henryclaessonVT/darpa-sense-hardware/Colossus/Colossus_TI_rev_B/Colossus_TI_rev_B Specific Libraries/xwing/1688178384_Starwarsshutlle1-3969009895.png

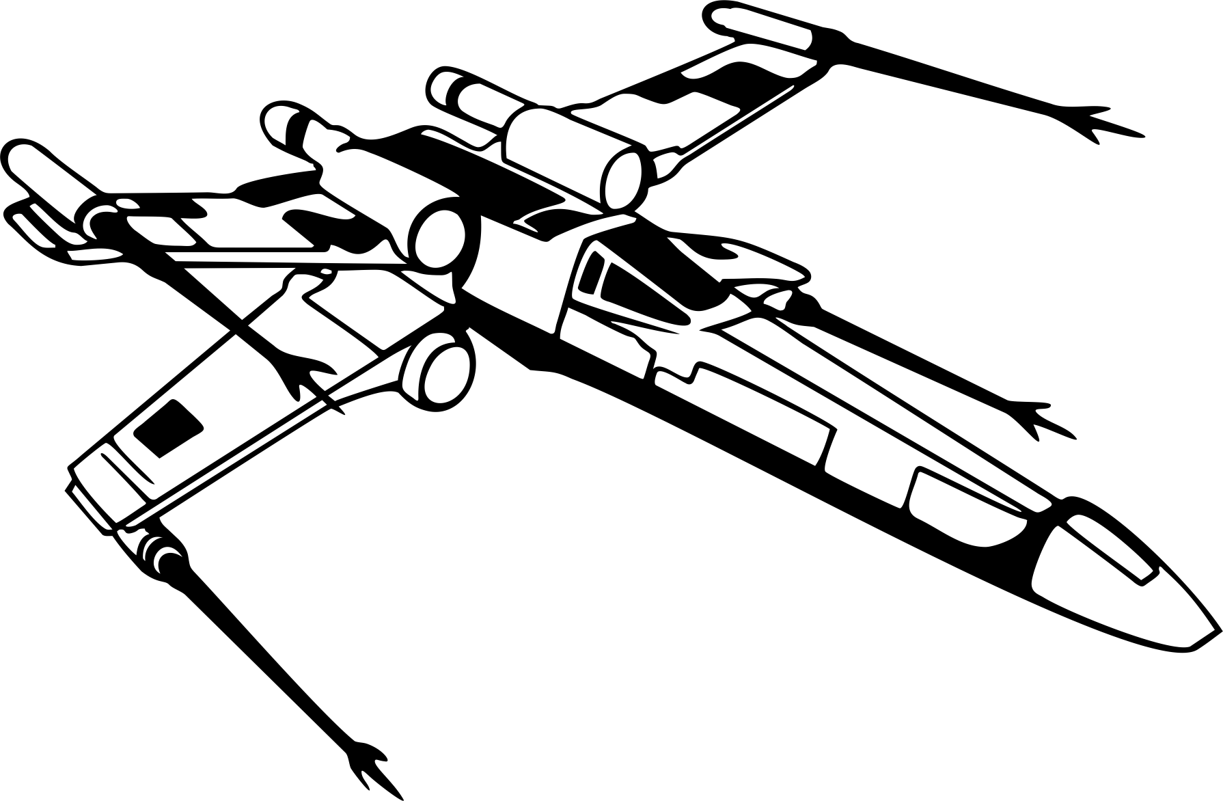
Colossus/Colossus_TI_rev_B/Colossus_TI_rev_B Specific Libraries/xwing/1688178384_Starwarsshutlle1-3969009895.png
