henryclaessonVT/darpa-sense-hardware/Colossus/Colossus_rev_C/Project Specific Libraries/LD56100DPU33R/DFN8_1P6X1P2_STM.step

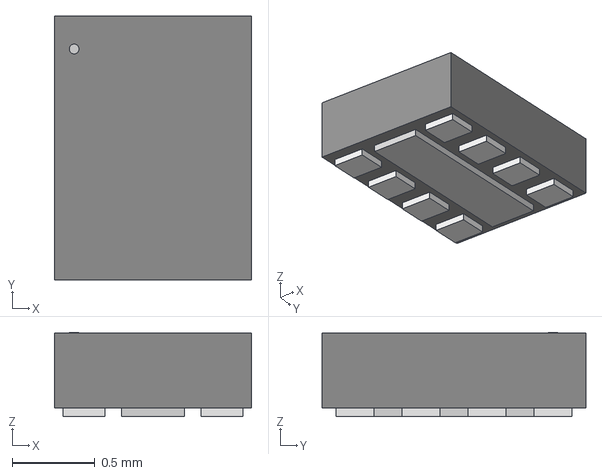
[picture p2: CAD file, 2025-03-21]
Colossus/Colossus_rev_C/Project Specific Libraries/LD56100DPU33R/DFN8_1P6X1P2_STM.step
1.19 x 1.60 x 0.511 mm
