henryclaessonVT/darpa-sense-hardware/Colossus/Colossus_rev_C/Project Specific Libraries/stm32/WLCSP39_STM.step

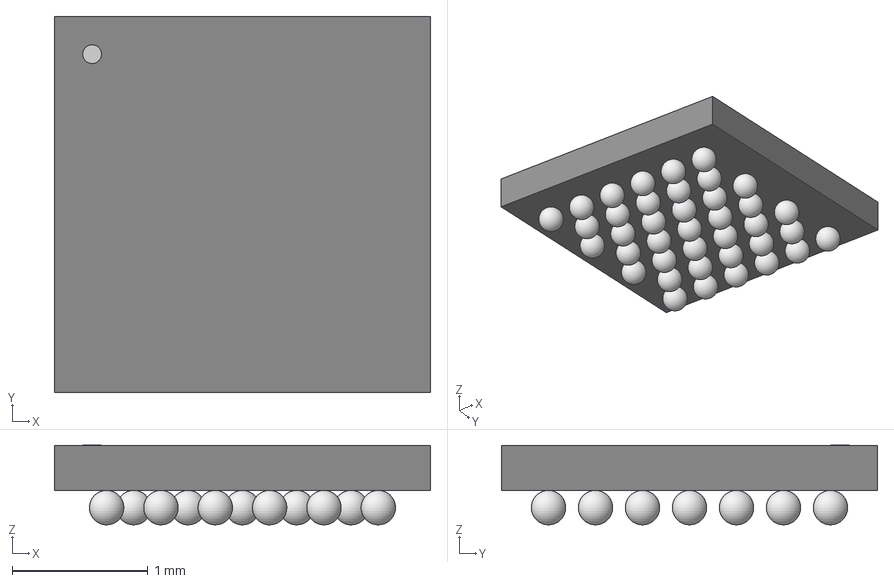
[picture p3: CAD file, 2025-03-21]
Colossus/Colossus_rev_C/Project Specific Libraries/stm32/WLCSP39_STM.step
2.77 x 2.77 x 0.587 mm
