henryclaessonVT/darpa-sense-hardware/Colossus/Colossus_TI_rev_B/Colossus_TI_rev_B Specific Libraries/Analog Switch - SN74LVC1G3157DSFR/SN74LVC1G3157DSFR.step

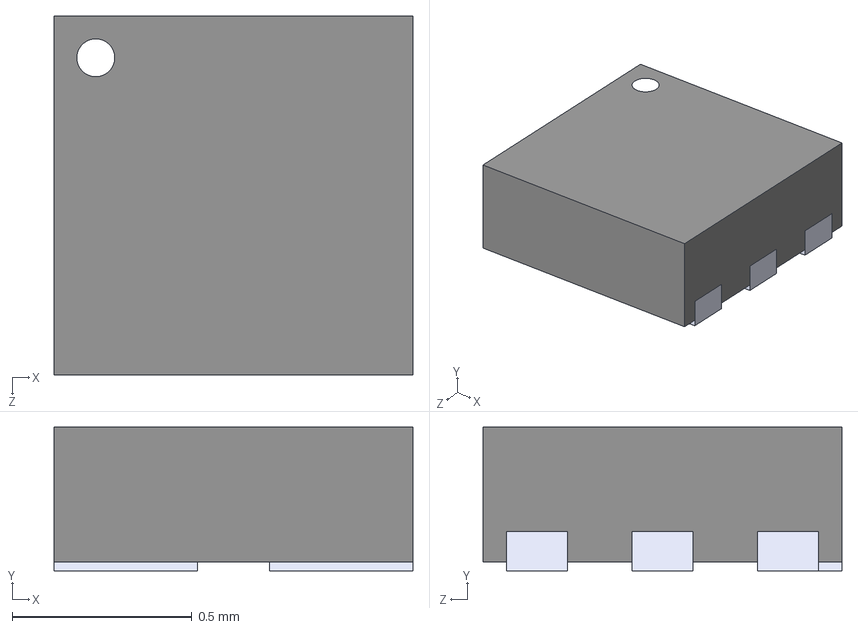
[picture p4: CAD file, 2025-08-12]
Colossus/Colossus_TI_rev_B/Colossus_TI_rev_B Specific Libraries/Analog Switch - SN74LVC1G3157DSFR/SN74LVC1G3157DSFR.step
1.00 x 0.4 x 1.00 mm
