henryclaessonVT/darpa-sense-hardware/Colossus/Colossus_TI_rev_B/Colossus_TI_rev_B Specific Libraries/G_107_0513 - Switch/G-107-0513.step

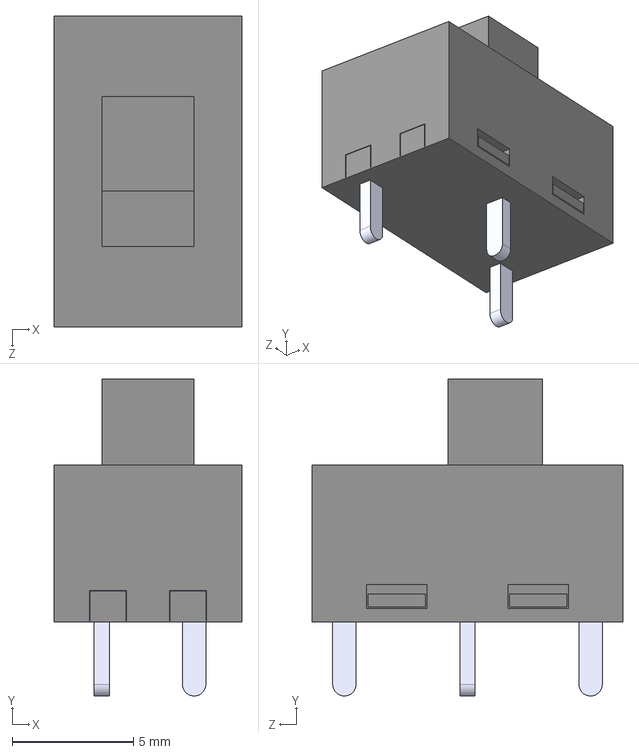
[picture p5: CAD file, 2025-04-02]
Colossus/Colossus_TI_rev_B/Colossus_TI_rev_B Specific Libraries/G_107_0513 - Switch/G-107-0513.step
7.75 x 13.1 x 12.8 mm
