henryclaessonVT/darpa-sense-hardware/Colossus/Colossus_TI_rev_B/Colossus_TI_rev_B.step

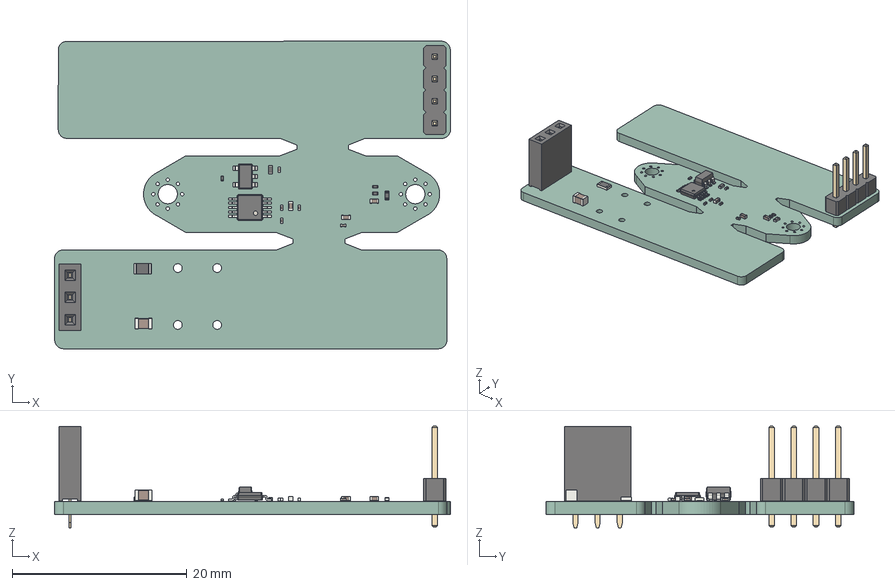
[picture p6: CAD file, 2025-08-12]
Colossus/Colossus_TI_rev_B/Colossus_TI_rev_B.step
45.3 x 35.2 x 11.6 mm
C_0402_1005Metric x 3
C_0201_0603Metric x 5
R_0201_0603Metric x 3
R_0402_1005Metric x 2
SOT-23-5
PinHeader_1x04_P2.54mm_Vertical
PinSocket_1x03_P2.54mm_Vertical
MSOP-10_3x3mm_P0.5mm
R_0805_2012Metric
C_0805_2012Metric
Colossus_TI_rev_B_PCB
