henryclaessonVT/darpa-sense-hardware/Colossus/Colossus_TI_rev_B/Colossus_TI_rev_B Specific Libraries/CSD18541F5 - n channel mosfet/CSD18541F5.step

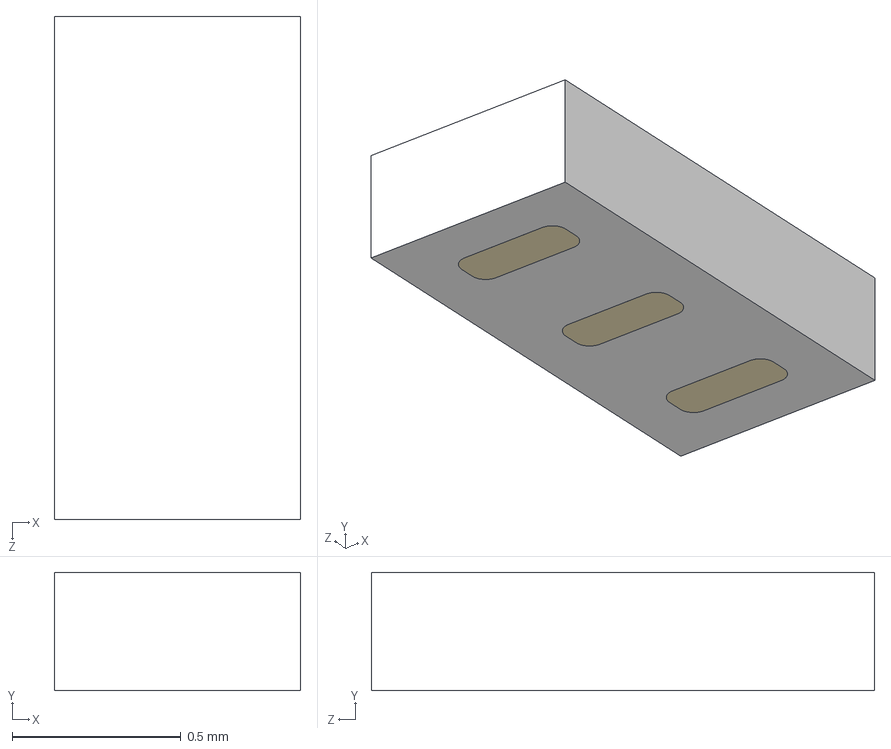
[picture p7: CAD file, 2025-05-27]
Colossus/Colossus_TI_rev_B/Colossus_TI_rev_B Specific Libraries/CSD18541F5 - n channel mosfet/CSD18541F5.step
0.73 x 0.35 x 1.49 mm
