henryclaessonVT/darpa-sense-hardware/(list of files, cad)

Other CAD files:
Colossus/Colossus_rev_C/Project Specific Libraries/WLCSP39_STM.step
