henryclaessonVT/darpa-sense-hardware/Colossus/Colossus_TI_rev_B/plots/Colossus_TI_rev_B__Assembly.pdf

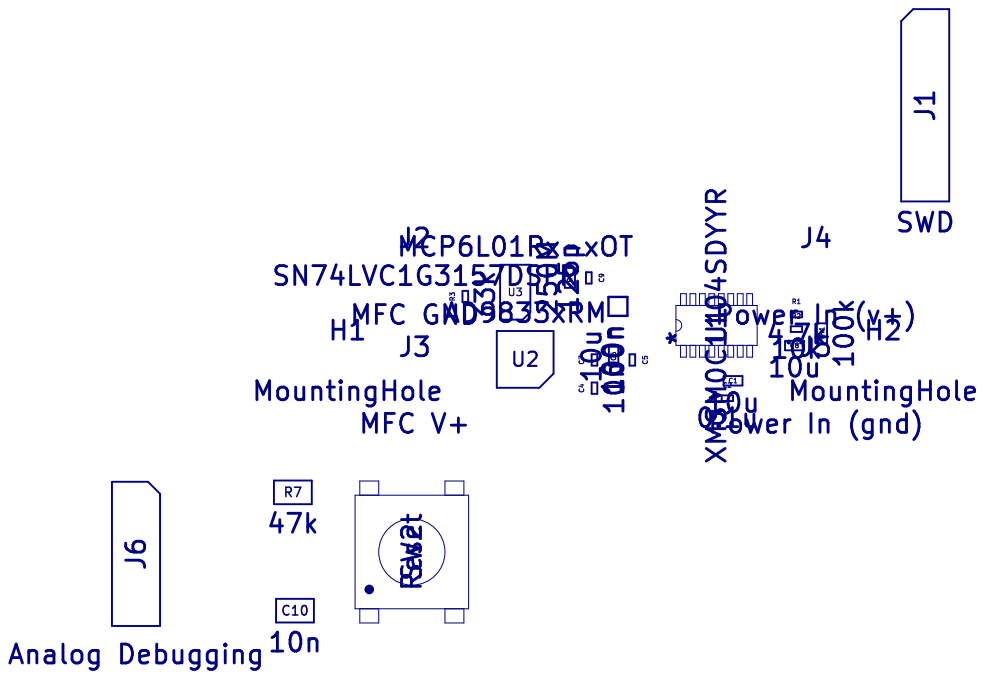
[picture p8: page 1]

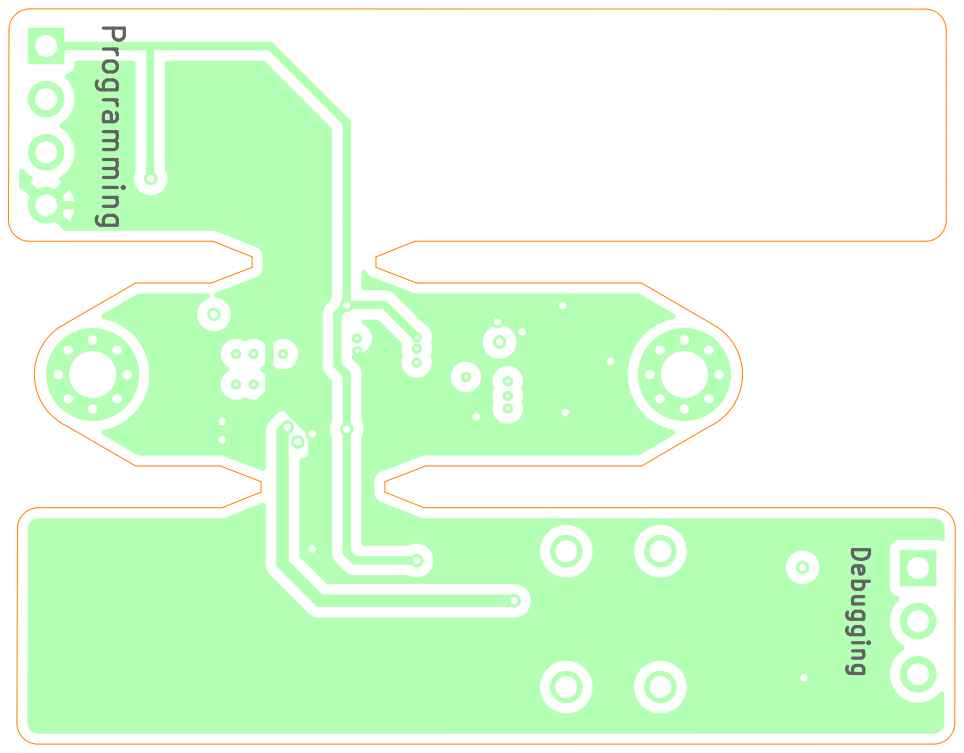
[picture p9: page 2]
Debugging Programming; D Date: KiCad; E.D.A. 9.0.1 Size: A4; Rev:; Id: /1 Title: File: Colossus_TI_rev_B.kicad_pcb Sheet: Colored; BOT Board2Pdf:; Colored; BOT -; Page 2/2
