henryclaessonVT/darpa-sense-hardware/Colossus/Colossus_TI_rev_B/Colossus_TI_rev_B.kicad_pcb

## KiCad design Colossus/Colossus_TI_rev_B/Colossus_TI_rev_B.kicad_pcb (2025-08-12)

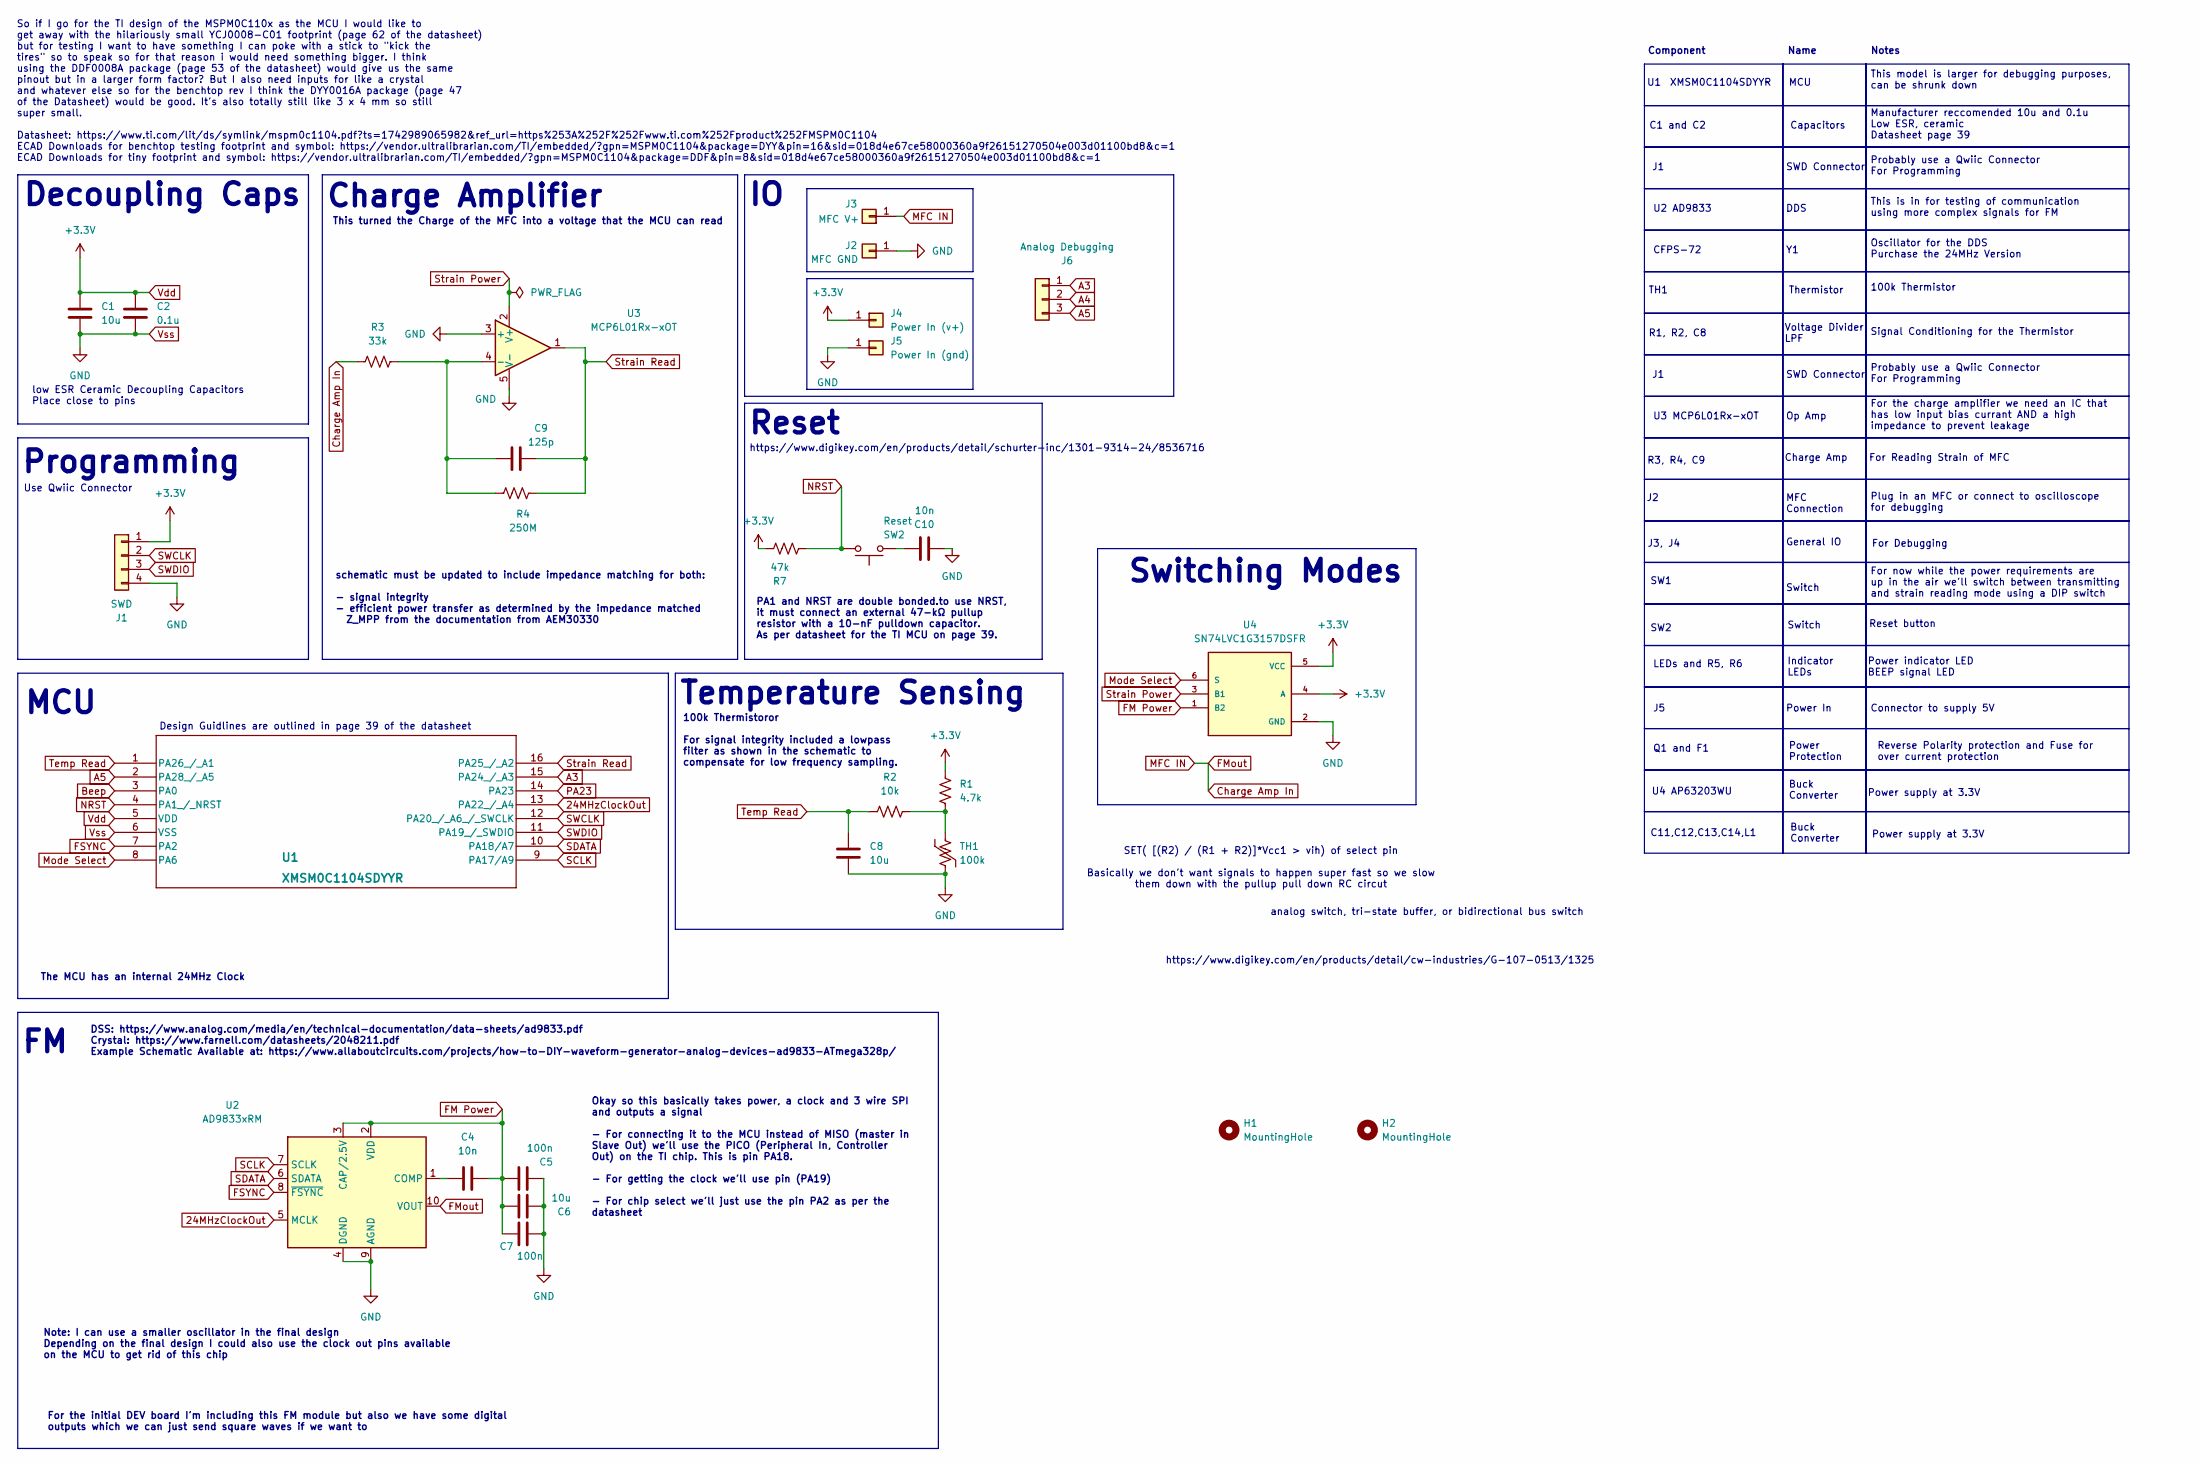
[picture p10: schematic Colossus_TI_rev_B.kicad_sch]

Parts:
C1, C6, C8: 10u; C_0402_1005Metric
C2: 0.1u; C_0201_0603Metric
C4: 10n; C_0201_0603Metric
C5, C7: 100n; C_0201_0603Metric
C9: 125p; C_0201_0603Metric
C10: 10n; C_0805_2012Metric
H1, H2: MountingHole; MountingHole_2.2mm_M2_Pad_Via
J1: SWD; PinHeader_1x04_P2.54mm_Vertical
J2: MFC GND; TestPoint_Pad_2.0x2.0mm
J3: MFC V+; TestPoint_Pad_2.0x2.0mm
J4: Power In (v+); TestPoint_Pad_2.0x2.0mm
J5: Power In (gnd); TestPoint_Pad_2.0x2.0mm
J6: Analog Debugging; PinSocket_1x03_P2.54mm_Vertical
R1: 4.7k; R_0201_0603Metric
R2: 10k; R_0201_0603Metric
R3: 33k; R_0201_0603Metric
R4: 250M; R_0402_1005Metric
R7: 47k; R_0805_2012Metric
SW2: Reset; SW_B3F-1000_OMR
TH1: 100k; R_0402_1005Metric
U1: XMSM0C1104SDYYR; SOT-23-THIN16_DYY_TEX
U2: AD9833xRM; MSOP-10_3x3mm_P0.5mm
U3: MCP6L01Rx-xOT; SOT-23-5
U4: SN74LVC1G3157DSFR; SON35P100X100X40-6N; PARTREV M

Connections:
24MHzClockOut: U1.13 (PA22_/_A4), U2.5 (MCLK)
A3: J6.1, U1.15 (PA24_/_A3)
A4: J6.2
A5: J6.3, U1.2 (PA28_/_A5)
Beep: U1.3 (PA0)
Charge Amp In: J3.1, R3.1, U2.10 (VOUT)
FM Power: C4.2, C5.2, C6.2, C7.1, U2.2 (VDD), U2.3 (CAP/2.5V), U4.1 (B2)
FSYNC: U1.7 (PA2), U2.8 (~FSYNC)
Mode Select: U1.8 (PA6), U4.6 (S)
NRST: R7.2, SW2.2, U1.4 (PA1_/_NRST)
unnamed: C10.2, SW2.1
unnamed: R1.2, R2.2, TH1.2
unnamed: C4.1, U2.1 (COMP)
unnamed: C9.1, R3.2, R4.1, U3.4 (-)
PA23: U1.14 (PA23)
SCLK: U1.9 (PA17/A9), U2.7 (SCLK)
SDATA: U1.10 (PA18/A7), U2.6 (SDATA)
SWCLK: J1.2, U1.12 (PA20_/_A6_/_SWCLK)
SWDIO: J1.3, U1.11 (PA19_/_SWDIO)
Strain Power: U3.2 (V+), U4.3 (B1)
Strain Read: C9.2, R4.2, U1.16 (PA25_/_A2), U3.1
Temp Read: C8.2, R2.1, U1.1 (PA26_/_A1)
Vdd: C1.1, C2.1, J1.1, J4.1, R1.1, R7.1, U1.5 (VDD), U4.4 (A), U4.5 (VCC)
Vss: C1.2, C2.2, C5.1, C6.1, C7.2, C8.1, C10.1, J1.4, J2.1, J5.1, TH1.1, U1.6 (VSS), U2.4 (DGND), U2.9 (AGND), U3.3 (+), U3.5 (V-), U4.2 (GND)

Notes on the sheet:
J3, J4
TH1
Buck Converter
DDS
For the initial DEV board I'm including this FM module but also we have some digital outputs which we can just send square waves if we want to
Notes
Power supply at 3.3V
Charge Amp
Design Guidlines are outlined in page 39 of the datasheet
Note: I can use a smaller oscillator in the final design Depending on the final design I could also use the clock out pins available on the MCU to get rid of this chip
Switch
low ESR Ceramic Decoupling Capacitors Place close to pins
C1 and C2
For the charge amplifier we need an IC that has low input bias currant AND a high impedance to prevent leakage
Power indicator LED BEEP signal LED
Temperature Sensing
Plug in an MFC or connect to oscilloscope for debugging
Voltage Divider LPF
U4 AP63203WU
General IO
Power Protection
analog switch, tri-state buffer, or bidirectional bus switch
Probably use a Qwiic Connector For Programming
For now while the power requirements are up in the air we'll switch between transmitting and strain reading mode using a DIP switch
Programming
U2 AD9833
Charge Amplifier
Manufacturer reccomended 10u and 0.1u Low ESR, ceramic Datasheet page 39
This turned the Charge of the MFC into a voltage that the MCU can read
schematic must be updated to include impedance matching for both: - signal integrity - efficient power transfer as determined by the impedance matched Z_MPP from the documentation from AEM30330
Switching Modes
Name
Power In
C11,C12,C13,C14,L1
Decoupling Caps
Capacitors
Connector to supply 5V
Use Qwiic Connector
SET( [(R2) / (R1 + R2)]*Vcc1 > vih) of select pin Basically we don't want signals to happen super fast so we slow them down with the pullup pull down RC circut
Component
CFPS-72
This is in for testing of communication using more complex signals for FM
MCU
For Reading Strain of MFC
This model is larger for debugging purposes, can be shrunk down
100k Thermistor
Reset
Q1 and F1
Oscillator for the DDS Purchase the 24MHz Version
SW2
The MCU has an internal 24MHz Clock
https://www.digikey.com/en/products/detail/schurter-inc/1301-9314-24/8536716
MFC Connection
U3 MCP6L01Rx-xOT
Op Amp
Indicator LEDs
R3, R4, C9
Thermistor
So if I go for the TI design of the MSPM0C110x as the MCU I would like to get away with the hilariously small YCJ0008-C01 footprint (page 62 of the datasheet) but for testing I want to have something I can poke with a stick to "kick the tires" so to speak so for that reason i would need something b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
Reverse Polarity protection and Fuse for over current protection
https://www.digikey.com/en/products/detail/cw-industries/G-107-0513/1325
SWD Connector
R1, R2, C8
PA1 and NRST are double bonded.to use NRST, it must connect an external 47-kΩ pullup resistor with a 10-nF pulldown capacitor. As per datasheet for the TI MCU on page 39.
Reset button
100k Thermistoror For signal integrity included a lowpass filter as shown in the schematic to compensate for low frequency sampling.
Signal Conditioning for the Thermistor
For Debugging
DSS: https://www.analog.com/media/en/technical-documentation/data-sheets/ad9833.pdf Crystal: https://www.farnell.com/datasheets/2048211.pdf Example Schematic Available at: https://www.allaboutcircuits.com/projects/how-to-DIY-waveform-generator-analog-devices-ad9833-ATmega328p/
XMSM0C1104SDYYR
LEDs and R5, R6
Okay so this basically takes power, a clock and 3 wire SPI and outputs a signal - For connecting it to the MCU instead of MISO (master in Slave Out) we'll use the PICO (Peripheral In, Controller Out) on the TI chip. This is pin PA18. - For getting the clock we'll use pin (PA19) - For chip select we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
SW1

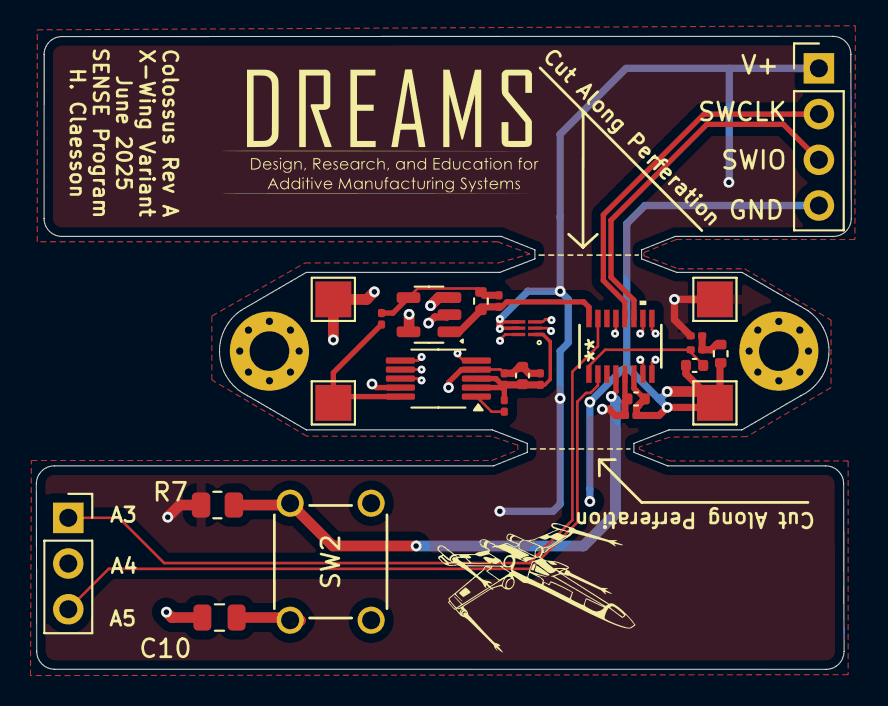
[picture p11: board Colossus_TI_rev_B.kicad_pcb from above]

Board: 4 copper layers, 45.3 x 35.2 mm, 28 parts (0 on the bottom side), 21 nets.
