henryclaessonVT/darpa-sense-hardware/Colossus/Colossus_rev_C/Colossus_rev_C.kicad_pcb

## KiCad design Colossus/Colossus_rev_C/Colossus_rev_C.kicad_pcb (2025-03-25)

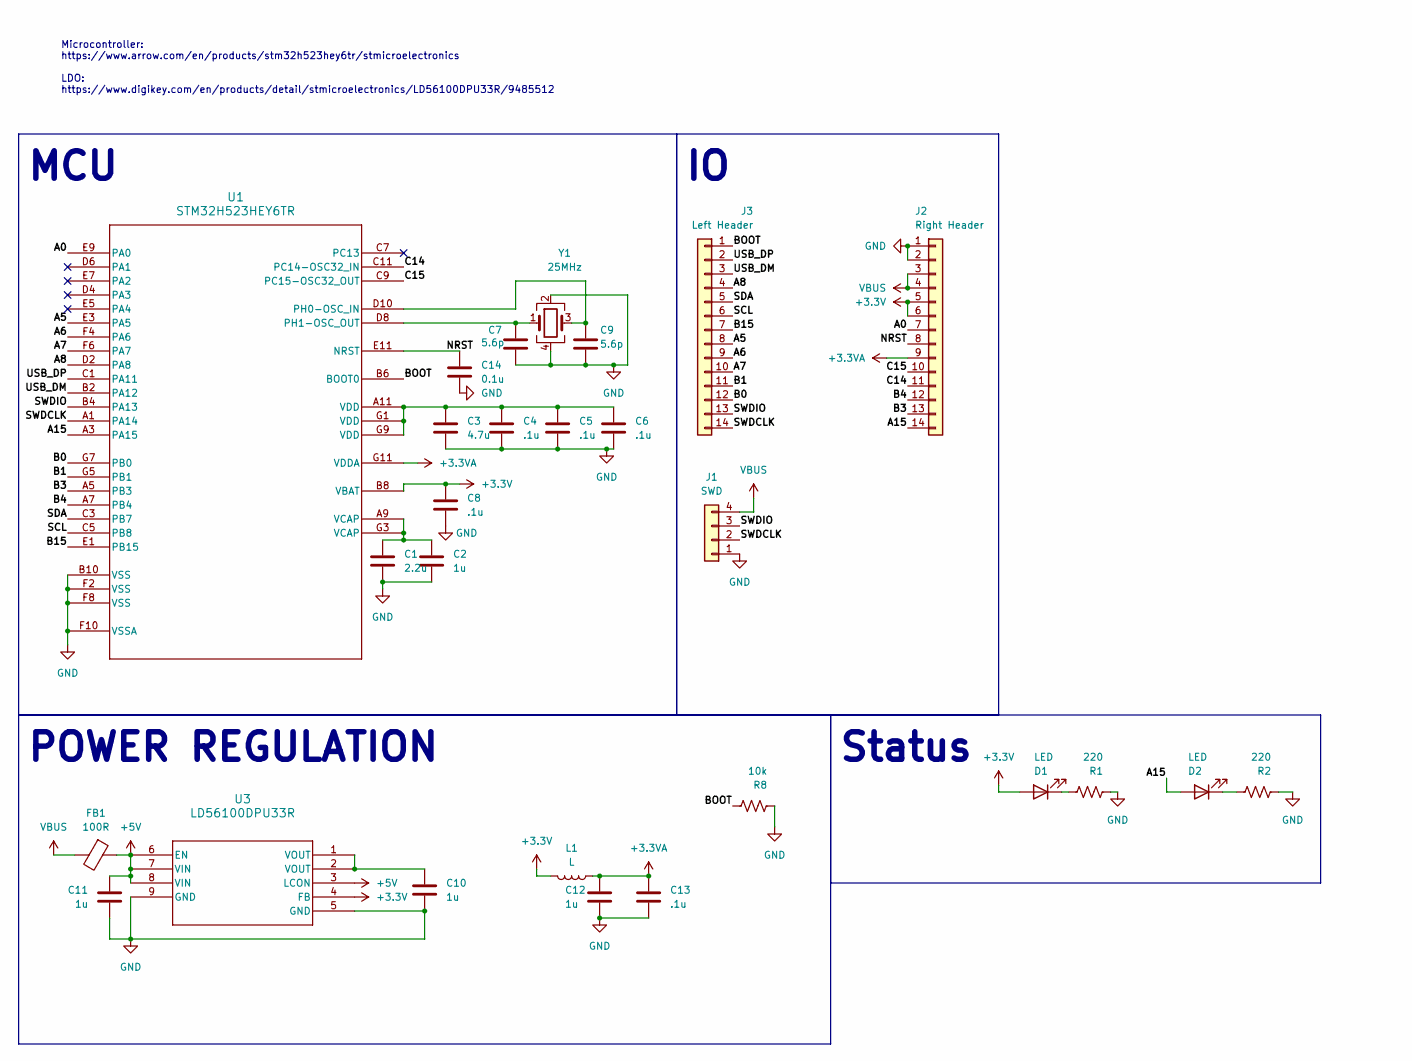
[picture p12: schematic Colossus_rev_C.kicad_sch, part in row 1, column 1]

Parts:
C1: 2.2u; C_0201_0603Metric
C2, C10, C11, C12: 1u; C_0201_0603Metric
C3: 4.7u; C_0201_0603Metric
C4, C5, C6, C8, C13: .1u; C_0201_0603Metric
C7, C9: 5.6p; C_0201_0603Metric
C14: 0.1u; C_0201_0603Metric
D1, D2: LED; LED_0201_0603Metric
FB1: 100R; LED_0201_0603Metric
J1: SWD; PinHeader_1x04_P1.00mm_Vertical
J2: Right Header; PinHeader_1x14_P1.27mm_Vertical
J3: Left Header; PinHeader_1x14_P1.27mm_Vertical
L1: L; L_0201_0603Metric
R1, R2: 220; R_01005_0402Metric
R8: 10k; R_01005_0402Metric
U1: STM32H523HEY6TR; WLCSP39_STM
U3: LD56100DPU33R; DFN8_1P6X1P2_STM-M
Y1: 25MHz; Oscillator_SMD_Abracon_ASCO-4Pin_1.6x1.2mm

Connections:
+3.3V: C8.1, D1.2 (A), J2.5, J2.6, L1.2, U1.B8 (VBAT), U3.4 (FB)
+3.3VA: C12.1, C13.1, J2.9, L1.1, U1.G11 (VDDA)
+5V: C11.1, FB1.1, U3.3 (LCON), U3.6 (EN), U3.7 (VIN), U3.8 (VIN)
/A0: J2.7, U1.E9 (PA0)
/A5: J3.8, U1.E3 (PA5)
/A6: J3.9, U1.F4 (PA6)
/A7: J3.10, U1.F6 (PA7)
/A8: J3.4, U1.D2 (PA8)
/A15: D2.2 (A), J2.14, U1.A3 (PA15)
/B0: J3.12, U1.G7 (PB0)
/B1: J3.11, U1.G5 (PB1)
/B3: J2.13, U1.A5 (PB3)
/B4: J2.12, U1.A7 (PB4)
/B15: J3.7, U1.E1 (PB15)
/BOOT: J3.1, R8.1, U1.B6 (BOOT0)
/C14: J2.11, U1.C11 (PC14-OSC32_IN)
/C15: J2.10, U1.C9 (PC15-OSC32_OUT)
/NRST: C14.1, J2.8, U1.E11 (NRST)
/SCL: J3.6, U1.C5 (PB8)
/SDA: J3.5, U1.C3 (PB7)
/SWDCLK: J1.2, J3.14, U1.A1 (PA14)
/SWDIO: J1.3, J3.13, U1.B4 (PA13)
/USB_DM: J3.3, U1.B2 (PA12)
/USB_DP: J3.2, U1.C1 (PA11)
GND: C1.2, C2.2, C3.2, C4.2, C5.2, C6.2, C7.2, C8.2, C9.2, C10.2, C11.2, C12.2, C13.2, C14.2, J1.1, J2.1, J2.2, R1.2, R2.2, R8.2, U1.B10 (VSS), U1.F2 (VSS), U1.F8 (VSS), U1.F10 (VSSA), U3.5 (GND), U3.9 (GND), Y1.2, Y1.4
unnamed: C1.1, C2.1, U1.A9 (VCAP), U1.G3 (VCAP)
unnamed: C3.1, C4.1, C5.1, C6.1, U1.A11 (VDD), U1.G1 (VDD), U1.G9 (VDD)
unnamed: C10.1, U3.1 (VOUT), U3.2 (VOUT)
unnamed: D1.1 (K), R1.1
unnamed: D2.1 (K), R2.1
unnamed: C9.1, U1.D10 (PH0-OSC_IN), Y1.3
unnamed: C7.1, U1.D8 (PH1-OSC_OUT), Y1.1
VBUS: FB1.2, J1.4, J2.3, J2.4

Notes on the sheet:
TODO: x Temperature Sensing Circuit o Strain Sensing Circuit -- skip this rev x IMU Circuit - MFC Communication Out Circuit - MFC Communication In Circuit - Energy Harvesting Circuit After that -- layout
Microcontroller: https://www.arrow.com/en/products/stm32h523hey6tr/stmicroelectronics LDO: https://www.digikey.com/en/products/detail/stmicroelectronics/LD56100DPU33R/9485512
MCU
POWER REGULATION
Status

Board: 2 copper layers, 27 parts (0 on the bottom side), 33 nets, no tracks yet.
