henryclaessonVT/darpa-sense-hardware/breakingboard/breakingboard.kicad_pcb

## KiCad design breakingboard/breakingboard.kicad_pcb (2025-01-02)

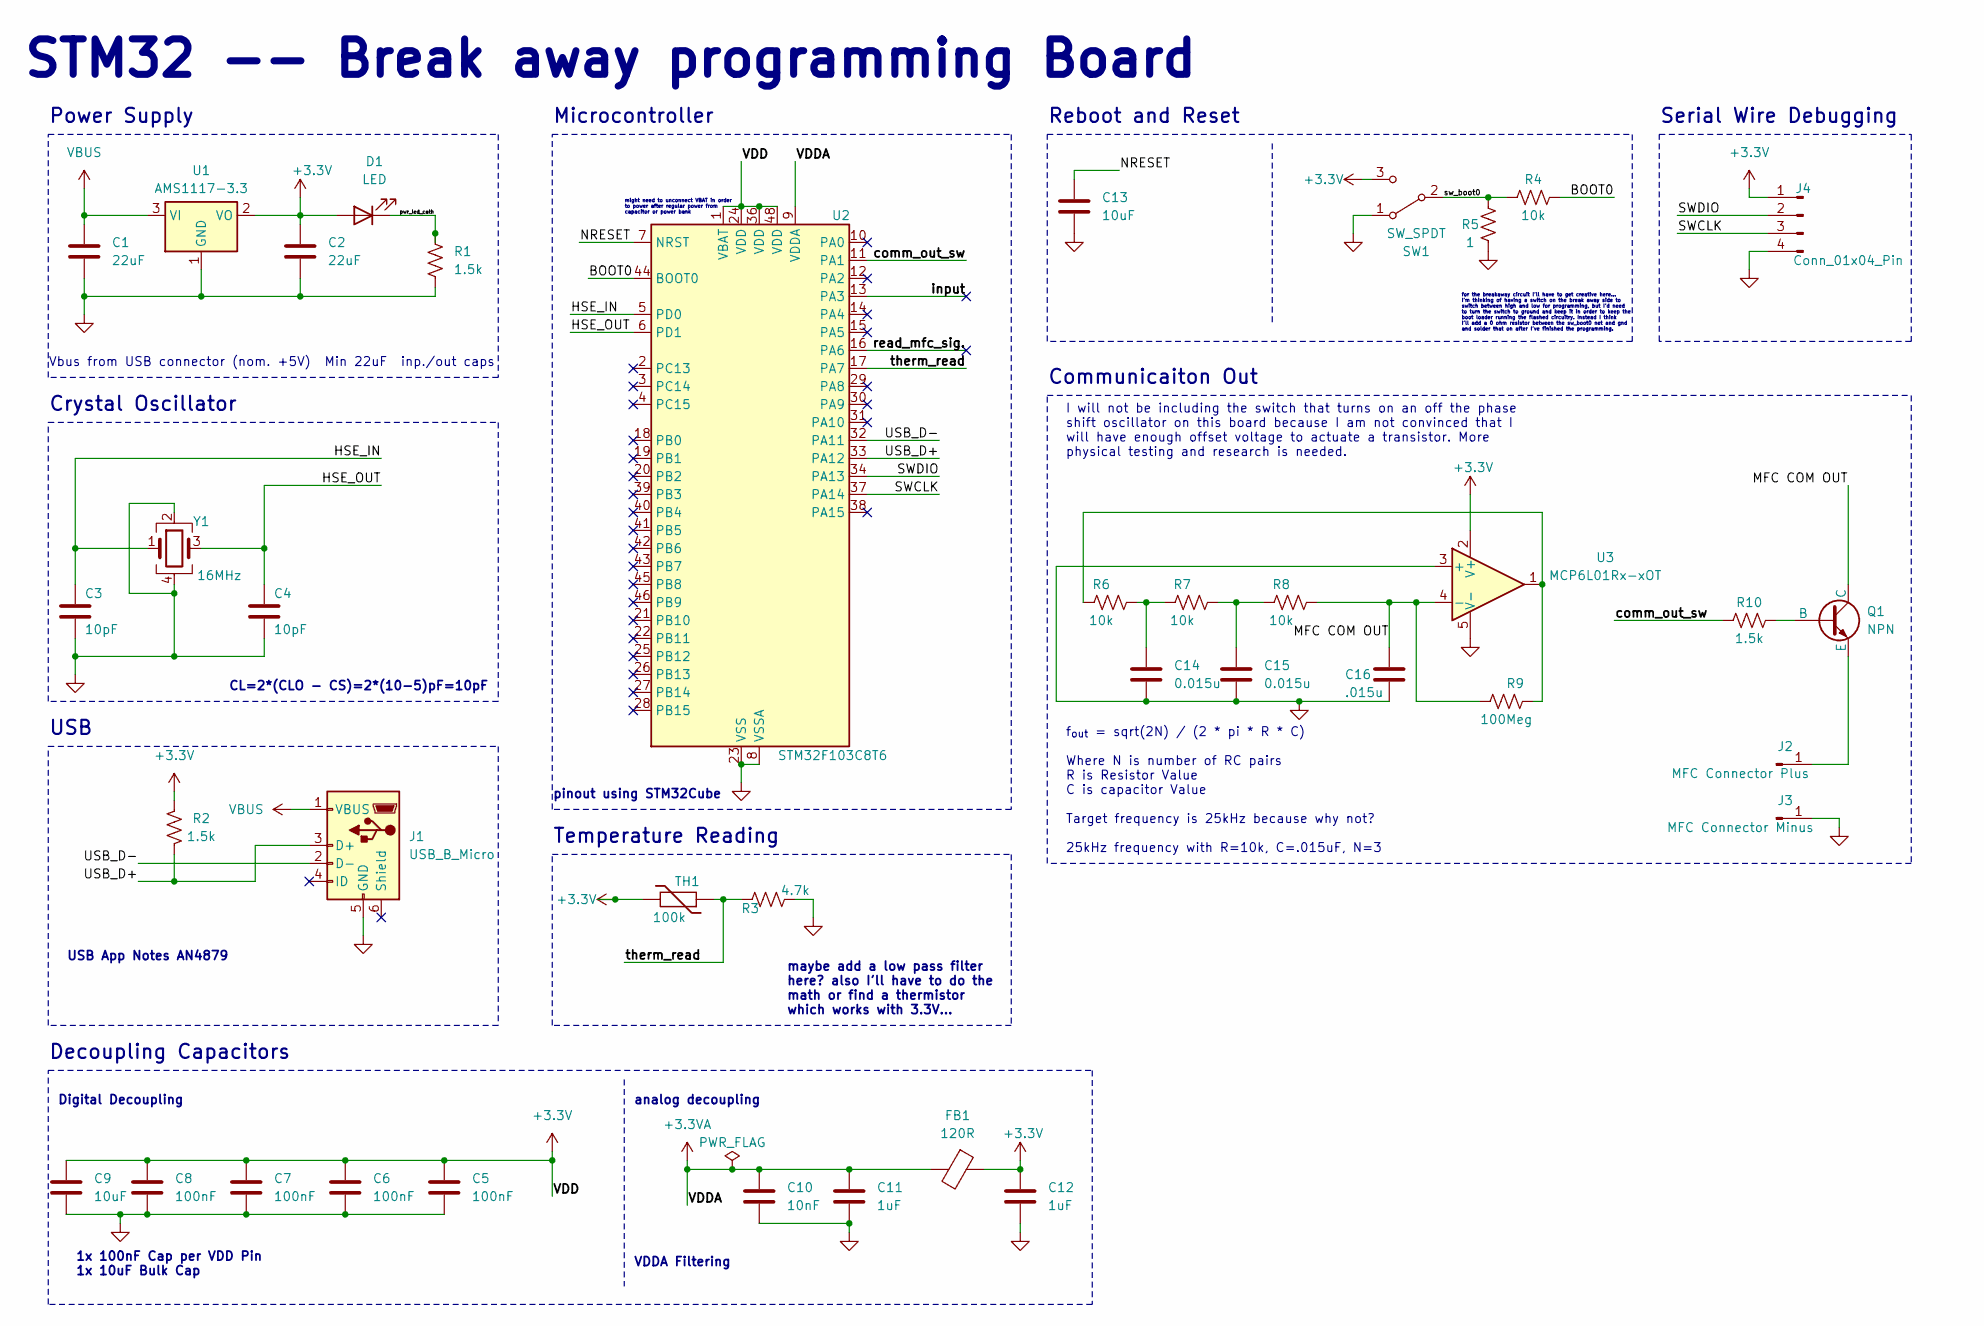
[picture p13: schematic breakingboard.kicad_sch, STM32 -- Break away programming Board]

Parts:
C1, C2: 22uF; C_0805_2012Metric
C3, C4: 10pF; C_0402_1005Metric
C5, C6, C7, C8: 100nF; C_0402_1005Metric
C9, C13: 10uF; C_0603_1608Metric
C10: 10nF; C_0402_1005Metric
C11, C12: 1uF; C_0402_1005Metric
C14, C15: 0.015u; C_0402_1005Metric
C16: .015u; C_0402_1005Metric
D1: LED; LED_0402_1005Metric
FB1: 120R; L_0603_1608Metric
J1: USB_B_Micro; USB_Micro-B_Wuerth_629105150521
J2: MFC Connector Plus; SolderWire-0.1sqmm_1x01_D0.4mm_OD1mm
J3: MFC Connector Minus; SolderWire-0.1sqmm_1x01_D0.4mm_OD1mm
J4: Conn_01x04_Pin; PinHeader_1x04_P2.54mm_Vertical
Q1: NPN; SOT-23
R1, R2, R10: 1.5k; R_0402_1005Metric
R3: 4.7k; R_0402_1005Metric
R4, R6, R7, R8: 10k; R_0402_1005Metric
R5: 1; R_0402_1005Metric
R9: 100Meg; R_0402_1005Metric
SW1: SW_SPDT; SW_SPDT_PCM12
TH1: 100k; R_0402_1005Metric
U1: AMS1117-3.3; SOT-223-3_TabPin2
U2: STM32F103C8T6; LQFP-48_7x7mm_P0.5mm
U3: MCP6L01Rx-xOT; SOT-23-5
Y1: 16MHz; Crystal_SMD_3225-4Pin_3.2x2.5mm

Connections:
+3.3V: C2.1, C5.1, C6.1, C7.1, C8.1, C9.1, C12.1, D1.2 (A), FB1.1, J4.1, R2.2, SW1.3 (C), TH1.2, U1.2 (VO), U2.1 (VBAT), U2.24 (VDD), U2.36 (VDD), U2.48 (VDD), U3.2 (V+)
+3.3VA: C10.1, C11.1, FB1.2, U2.9 (VDDA)
/BOOT0: R4.2, U2.44 (BOOT0)
/HSE_IN: C3.1, U2.5 (PD0), Y1.1
/HSE_OUT: C4.1, U2.6 (PD1), Y1.3
/MFC COM OUT: C16.1, Q1.1 (C), R8.2, R9.1, U3.4 (-)
/NRESET: C13.1, U2.7 (NRST)
/SWCLK: J4.3, U2.37 (PA14)
/SWDIO: J4.2, U2.34 (PA13)
/USB_D+: J1.3 (D+), R2.1, U2.33 (PA12)
/USB_D-: J1.2 (D-), U2.32 (PA11)
/comm_out_sw: R10.1, U2.11 (PA1)
/input: U2.13 (PA3)
/pwr_led_cath: D1.1 (K), R1.1
/read_mfc_sig.: U2.16 (PA6)
/sw_boot0: R4.1, R5.2, SW1.2 (B)
/therm_read: R3.2, TH1.1, U2.17 (PA7)
GND: C1.2, C2.2, C3.2, C4.2, C5.2, C6.2, C7.2, C8.2, C9.2, C10.2, C11.2, C12.2, C13.2, C14.2, C15.2, C16.2, J1.5 (GND), J3.1, J4.4, R1.2, R3.1, R5.1, SW1.1 (A), U1.1 (GND), U2.8 (VSSA), U2.23 (VSS), U2.35 (VSS), U2.47 (VSS), U3.3 (+), U3.5 (V-), Y1.2, Y1.4
unnamed: C14.1, R6.2, R7.1
unnamed: C15.1, R7.2, R8.1
unnamed: J2.1, Q1.3 (E)
unnamed: Q1.2 (B), R10.2
unnamed: R6.1, R9.2, U3.1
VBUS: C1.1, J1.1 (VBUS), U1.3 (VI)

Notes on the sheet:
VDDA Filtering
might need to unconnect VBAT in order to power after regular power from capacitor or power bank
CL=2*(CLO - CS)=2*(10-5)pF=10pF
Microcontroller
Temperature Reading
Serial Wire Debugging
maybe add a low pass filter here? also I'll have to do the math or find a thermistor which works with 3.3V...
Reboot and Reset
I will not be including the switch that turns on an off the phase shift oscillator on this board because I am not convinced that I will have enough offset voltage to actuate a transistor. More physical testing and research is needed.
Communicaiton Out
Decoupling Capacitors
for the breakaway circuit I'll have to get creative here... I'm thinking of having a switch on the break away side to switch between high and low for programming, but I'd need to turn the switch to ground and keep it in order to keep the boot loader running the flashed circuitry. Instead I think I'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
f_{out} = sqrt(2N) / (2 * pi * R * C) Where N is number of RC pairs R is Resistor Value C is capacitor Value Target frequency is 25kHz because why not? 25kHz frequency with R=10k, C=.015uF, N=3
pinout using STM32Cube
Crystal Oscillator
Power Supply
1x 100nF Cap per VDD Pin 1x 10uF Bulk Cap
STM32 -- Break away programming Board
Digital Decoupling
analog decoupling
USB
Vbus from USB connector (nom. +5V) Min 22uF inp./out caps
USB App Notes AN4879

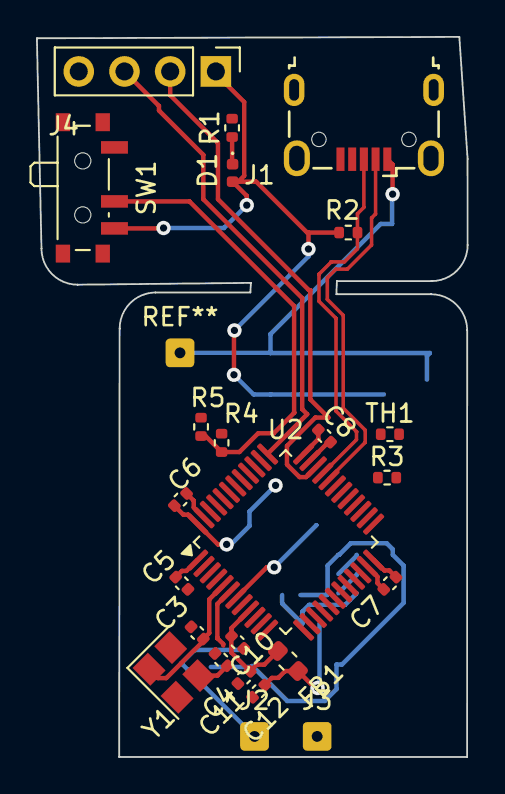
[picture p14: board breakingboard.kicad_pcb from above]

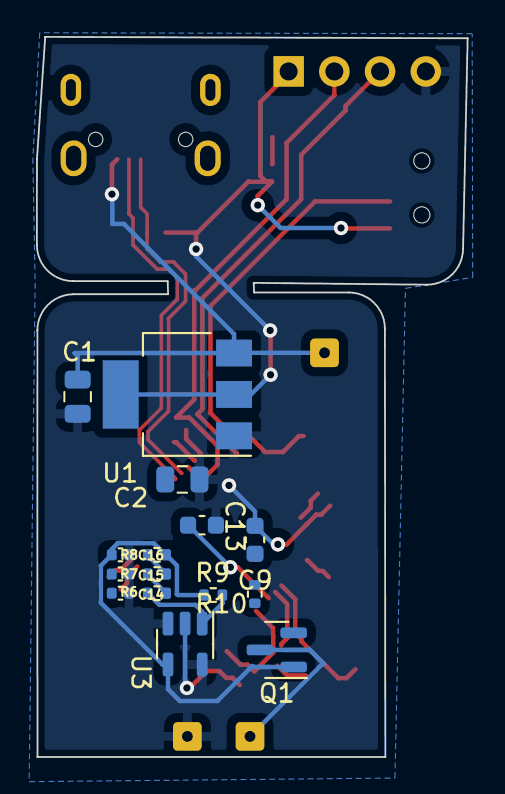
[picture p15: board breakingboard.kicad_pcb from below]

Board: 2 copper layers, 23.9 x 40.0 mm, 39 parts (15 on the bottom side), 22 nets.
