henryclaessonVT/darpa-sense-hardware/straingaugeboard_v3/straingaugeboard_v3.kicad_pcb

## KiCad design straingaugeboard_v3/straingaugeboard_v3.kicad_pcb (2024-11-11, an earlier design)

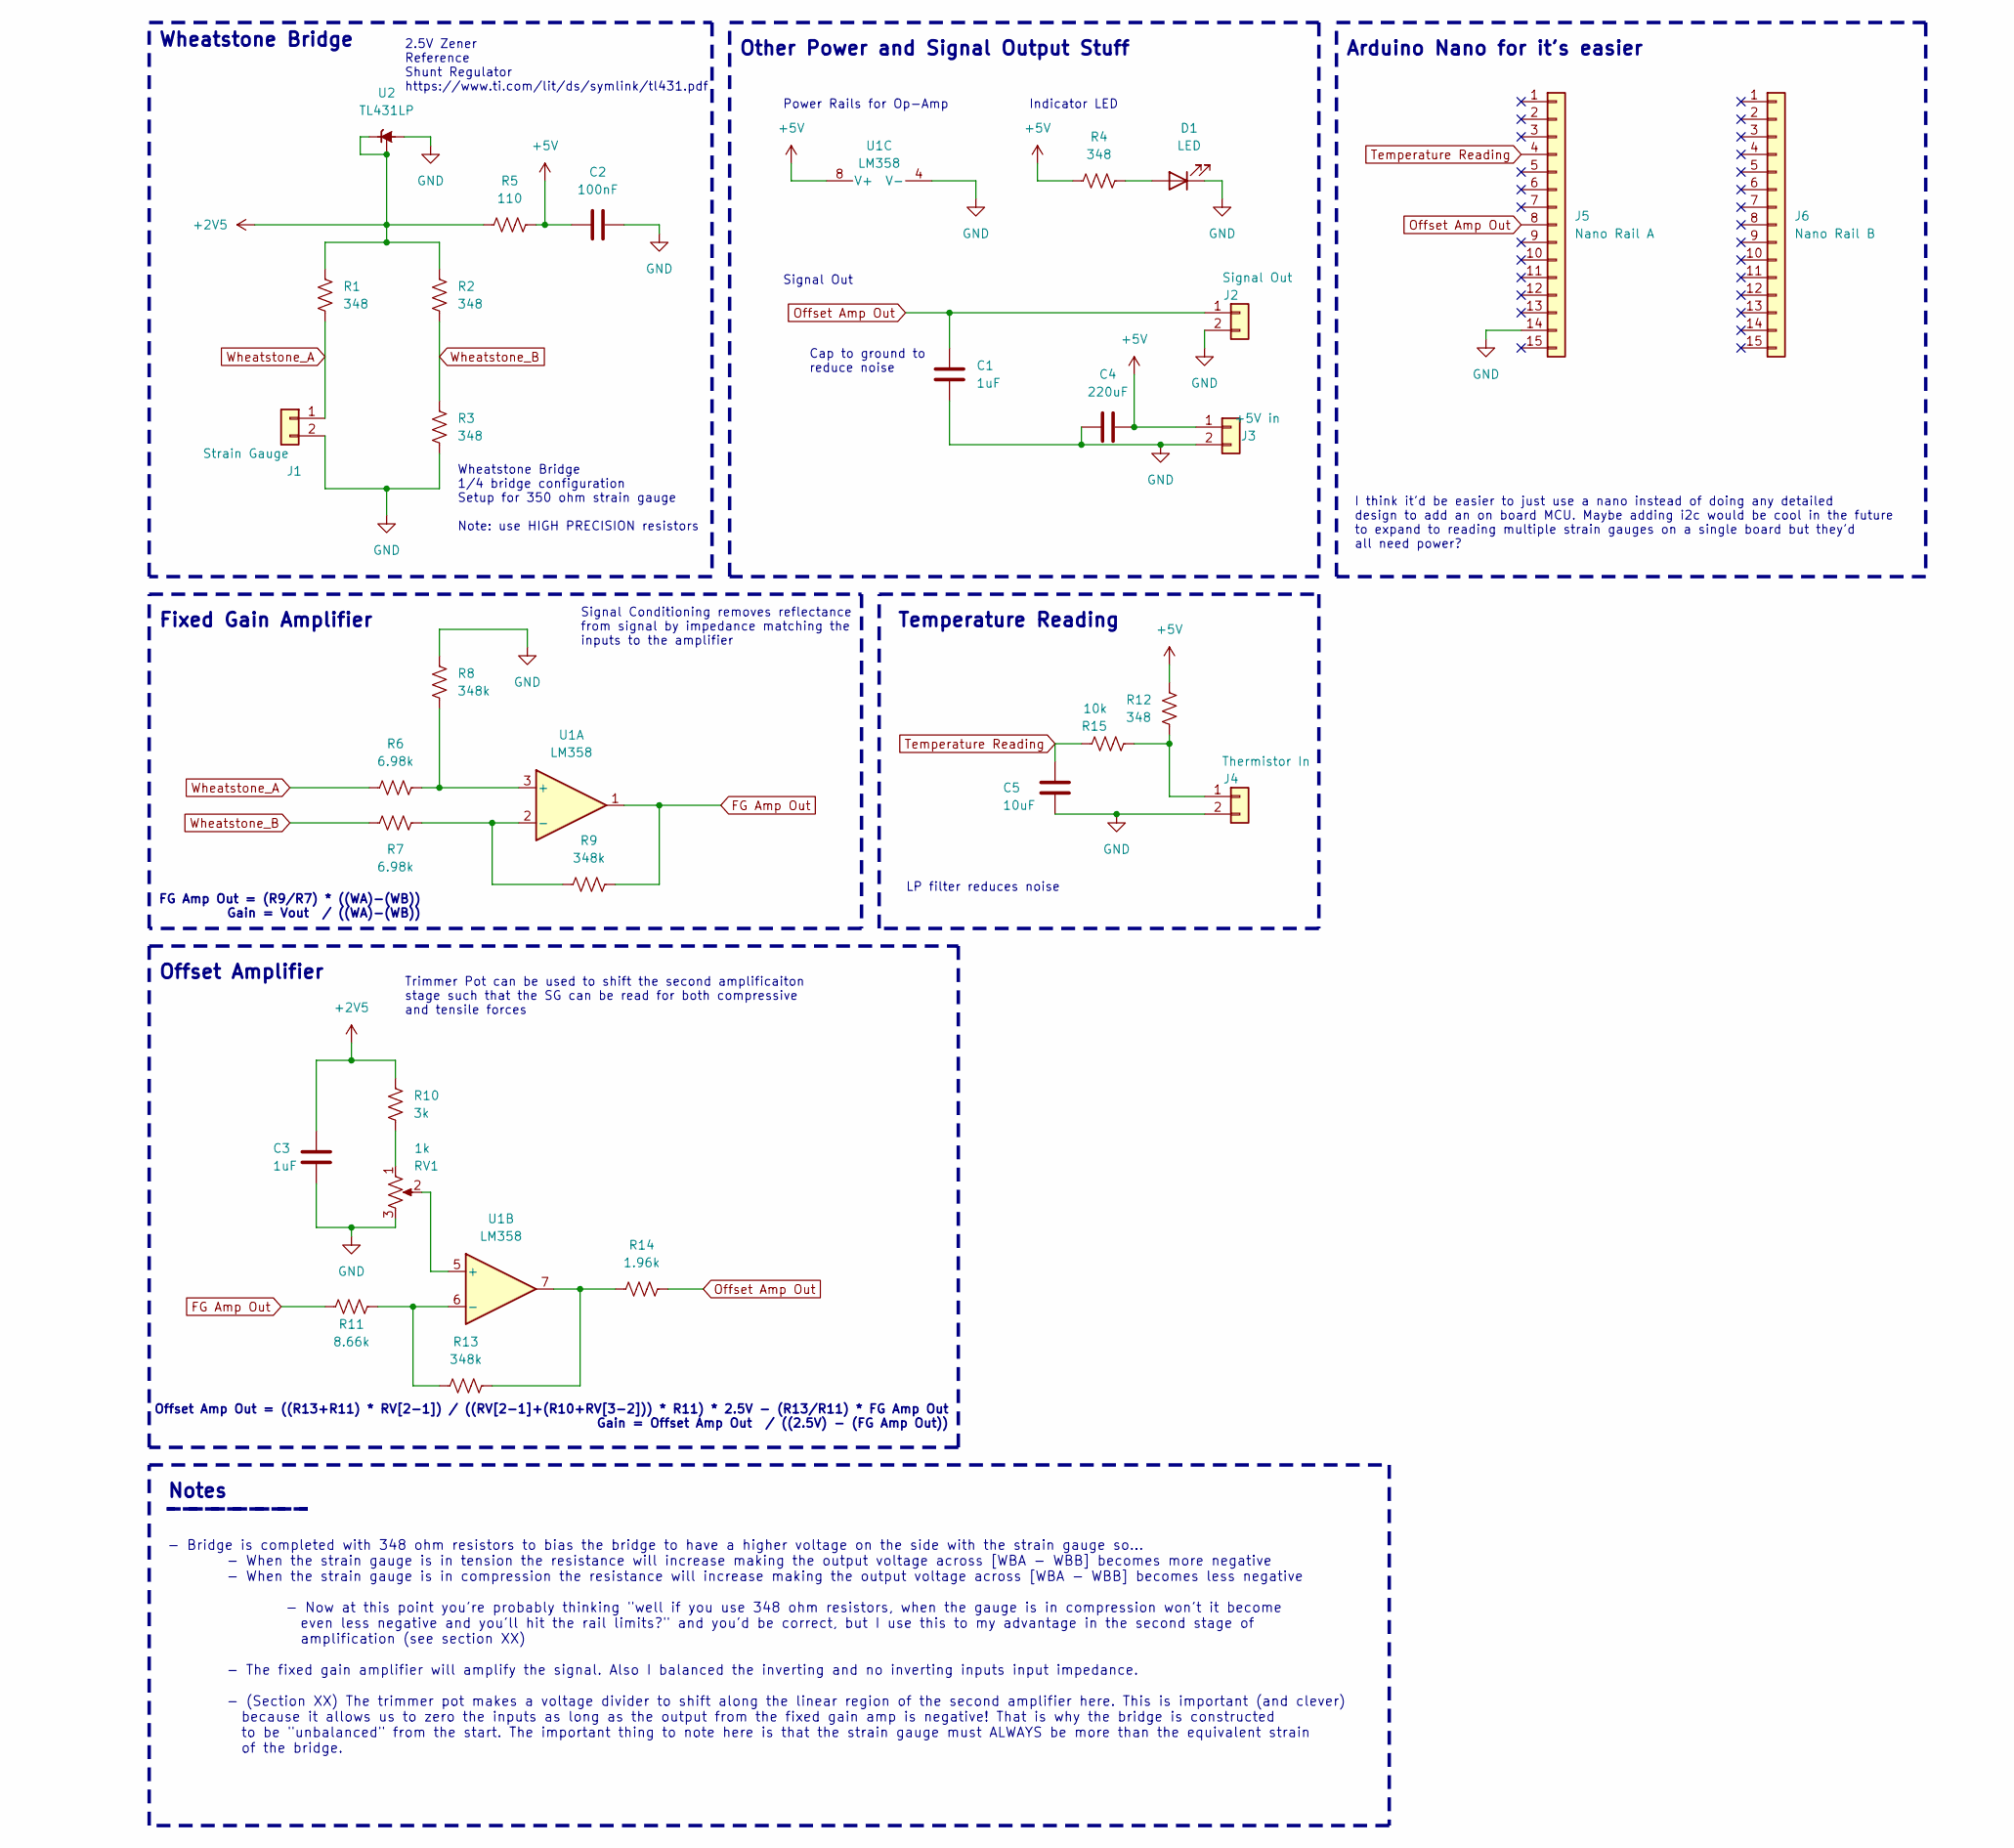
[picture p16: schematic straingaugeboard_v3.kicad_sch]

Parts:
C1, C3: 1uF; C_1206_3216Metric
C2: 100nF; C_1206_3216Metric
C4: 220uF; C_1206_3216Metric
C5: 10uF; C_1206_3216Metric
D1: LED; LED_1206_3216Metric
J1: Strain Gauge; TerminalBlock_Phoenix_MKDS-1,5-2-5.08_1x02_P5.08mm_Horizont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
J2: Signal Out; TerminalBlock_Phoenix_MKDS-1,5-2-5.08_1x02_P5.08mm_Horizont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
J3: +5V in; BarrelJack_CUI_PJ-063AH_Horizontal
J4: Thermistor In; TerminalBlock_Phoenix_MKDS-1,5-2-5.08_1x02_P5.08mm_Horizont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
J5: Nano Rail A; PinSocket_1x15_P2.54mm_Vertical
J6: Nano Rail B; PinSocket_1x15_P2.54mm_Vertical
R1: 348; LED_1206_3216Metric
R2, R3, R4, R12: 348; R_1206_3216Metric
R5: 110; R_1206_3216Metric
R6, R7: 6.98k; R_1206_3216Metric
R8, R9, R13: 348k; R_1206_3216Metric
R10: 3k; R_1206_3216Metric
R11: 8.66k; R_1206_3216Metric
R14: 1.96k; R_1206_3216Metric
R15: 10k; R_1206_3216Metric
RV1: 1k; Potentiometer_Bourns_3266Y_Vertical
U1: LM358; DIP-8_W7.62mm
U2: TL431LP; TO-92_Inline

Connections:
+2V5: C3.1, R1.1, R2.1, R5.1, R10.1, U2.1 (REF), U2.3 (K)
+5V: C2.1, C4.2, J3.1, R4.1, R5.2, R12.1, U1.8 (V+)
FG Amp Out: R9.1, R11.1, U1.1
GND: C1.2, C2.2, C3.2, C4.1, C5.1, D1.1 (K), J1.2, J2.2, J3.2, J4.2, J5.14, R3.2, R8.2, RV1.3, U1.4 (V-), U2.2 (A)
unnamed: D1.2 (A), R4.2
unnamed: J4.1, R12.2, R15.2
unnamed: R10.2, RV1.1
unnamed: R13.1, R14.2, U1.7
unnamed: R6.2, R8.1, U1.3 (+)
unnamed: R7.2, R9.2, U1.2 (-)
unnamed: RV1.2, U1.5 (+)
unnamed: R11.2, R13.2, U1.6 (-)
Offset Amp Out: C1.1, J2.1, J5.8, R14.1
Temperature Reading: C5.2, J5.4, R15.1
Wheatstone_A: J1.1, R1.2, R6.1
Wheatstone_B: R2.2, R3.1, R7.1

Notes on the sheet:
- Bridge is completed with 348 ohm resistors to bias the bridge to have a higher voltage on the side with the strain gauge so... - When the strain gauge is in tension the resistance will increase making the output voltage across [WBA - WBB] becomes more negative - When the strain gauge is in compre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
Cap to ground to reduce noise
Offset Amplifier
Fixed Gain Amplifier
Wheatstone Bridge 1/4 bridge configuration Setup for 350 ohm strain gauge Note: use HIGH PRECISION resistors
FG Amp Out = (R9/R7) * ((WA)-(WB)) Gain = Vout / ((WA)-(WB))
Arduino Nano for it's easier
2.5V Zener Reference Shunt Regulator https://www.ti.com/lit/ds/symlink/tl431.pdf
Signal Out
Signal Conditioning removes reflectance from signal by impedance matching the inputs to the amplifier
Indicator LED
Trimmer Pot can be used to shift the second amplificaiton stage such that the SG can be read for both compressive and tensile forces
Notes
Other Power and Signal Output Stuff
I think it'd be easier to just use a nano instead of doing any detailed design to add an on board MCU. Maybe adding i2c would be cool in the future to expand to reading multiple strain gauges on a single board but they'd all need power?
Temperature Reading
Offset Amp Out = ((R13+R11) * RV[2-1]) / ((RV[2-1]+(R10+RV[3-2])) * R11) * 2.5V - (R13/R11) * FG Amp Out Gain = Offset Amp Out / ((2.5V) - (FG Amp Out))
LP filter reduces noise
Power Rails for Op-Amp
Wheatstone Bridge

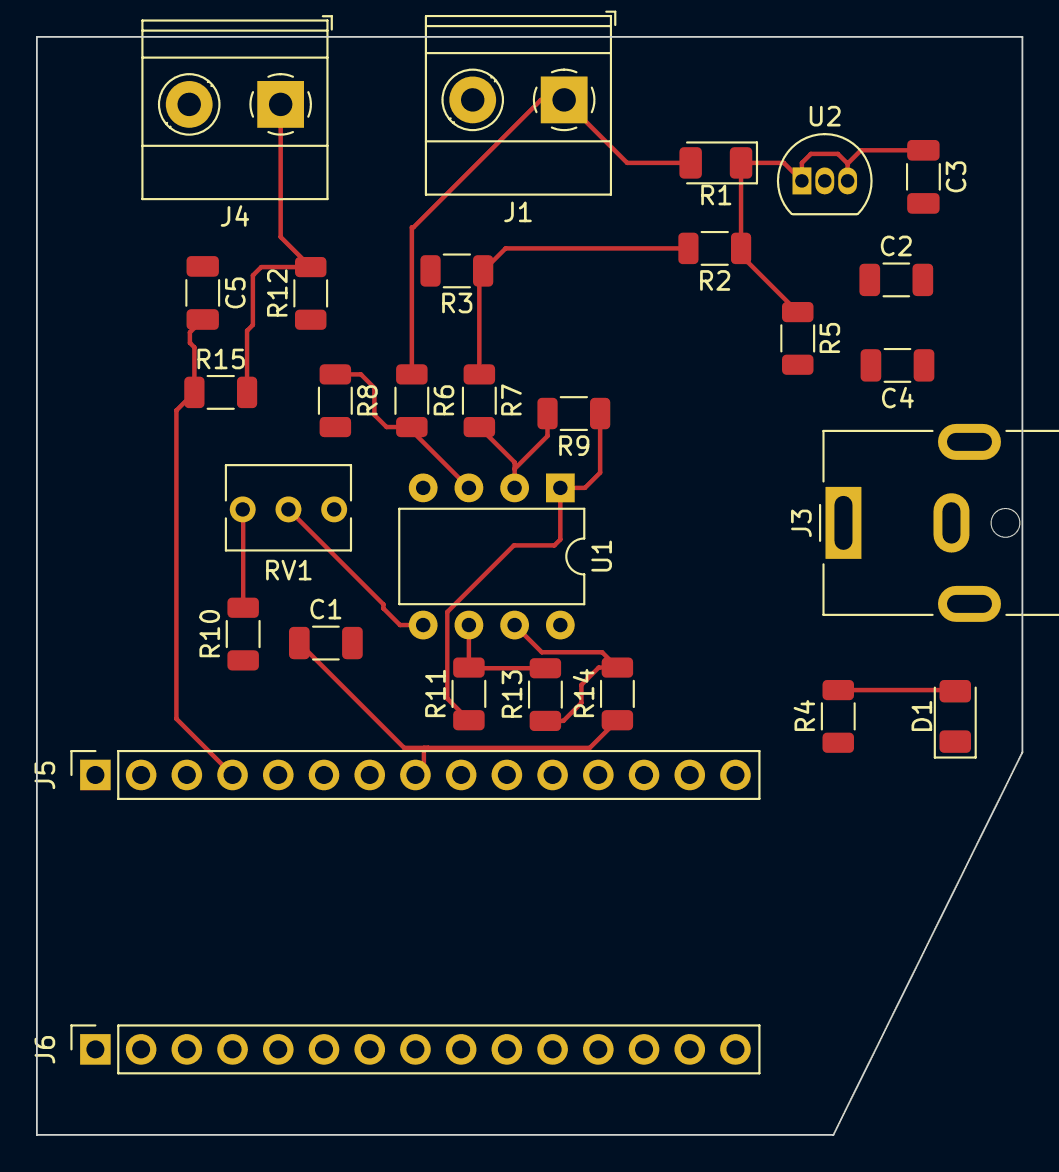
[picture p17: board straingaugeboard_v3.kicad_pcb from above]

Board: 2 copper layers, 54.8 x 61.0 mm, 29 parts (0 on the bottom side), 16 nets.
