henryclaessonVT/darpa-sense-hardware/(commit log)

2024-11-11 add my files
    [straingaugeboard_v1.kicad_pcb, straingaugeboard_v1.kicad_sch, straingaugeboard_v3.kicad_pcb, straingaugeboard_v3.kicad_sch, straingaugeboard_v4.kicad_pcb, straingaugeboard_v4.kicad_sch, straingaugeboard_v5.kicad_pcb, straingaugeboard_v5.kicad_sch]
2025-01-02 pushing to save
    [breakingboard.kicad_pcb, breakingboard.kicad_sch]
2025-03-21 pushing to desktop
    [Colossus_rev_A.kicad_pcb, Colossus_rev_A.kicad_sch, DFN8_1P6X1P2_STM.step, Energy Harvesting.kicad_sch, IMU.kicad_sch, MFC_COMM_IN.kicad_sch, MFC_COMM_OUT.kicad_sch, Strain Sensing.kicad_sch]
2025-03-25 pushing for desktop
    [Colossus_rev_C.kicad_pcb, Colossus_rev_C.kicad_sch, DFN8_1P6X1P2_STM.step, Energy Harvesting.kicad_sch, IMU.kicad_sch, MFC_COMM_IN.kicad_sch, MFC_COMM_OUT.kicad_sch, Strain Sensing.kicad_sch]
2025-04-02 adding ti board
    [Colossus_TI_rev_A-B_Mask.gbr, Colossus_TI_rev_A-B_Paste.gbr, Colossus_TI_rev_A-B_Silkscreen.gbr, Colossus_TI_rev_A-Back.gbr, Colossus_TI_rev_A-Edge_Cuts.gbr, Colossus_TI_rev_A-F_Mask.gbr, Colossus_TI_rev_A-F_Paste.gbr, Colossus_TI_rev_A-F_Silkscreen.gbr]
2025-05-27 proto of rev b coloccus
    [CSD18541F5.step, Colossus_TI_rev_B.kicad_pcb, Colossus_TI_rev_B.kicad_sch, Colossus_rev_B.csv, Colossus_rev_B.kicad_pcb, Colossus_rev_B.kicad_sch, Colossus_rev_B.sch, G-107-0513.step]
2025-06-10 working on miniaturization
    [Colossus_TI_rev_B.kicad_pcb, Colossus_TI_rev_B.kicad_sch]
2025-06-12 pushing to take the trian to family day
    [Colossus_TI_rev_B.kicad_pcb]
2025-08-12 final and manufactured draft of revB board
    [Colossus_TI_rev_B-B_Mask.gbr, Colossus_TI_rev_B-B_Paste.gbr, Colossus_TI_rev_B-B_Silkscreen.gbr, Colossus_TI_rev_B-Back.gbr, Colossus_TI_rev_B-Edge_Cuts.gbr, Colossus_TI_rev_B-F_Mask.gbr, Colossus_TI_rev_B-F_Paste.gbr, Colossus_TI_rev_B-F_Silkscreen.gbr]
